DayControls/ESP32_Universal_Controller/IMAGES/ESP32-CTRL-V1_Detail2.png

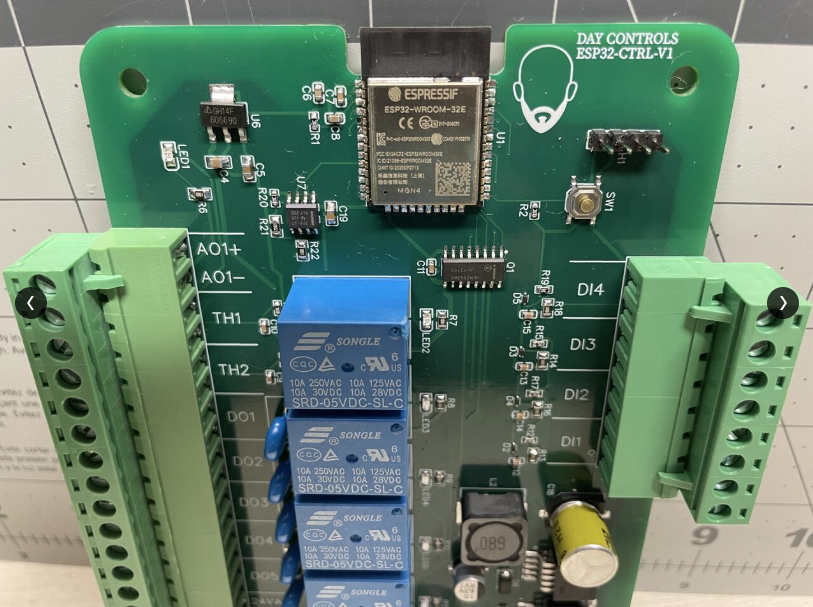
IMAGES/ESP32-CTRL-V1_Detail2.png
