DayControls/ESP32_Universal_Controller/IMAGES/ESP32-CTRL-V1_Completed.png

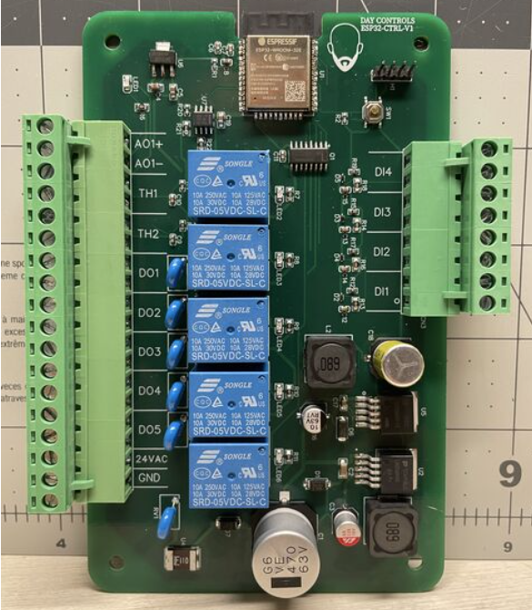
IMAGES/ESP32-CTRL-V1_Completed.png
