DayControls/ESP32_Universal_Controller/README.md

# Universal Programmable Logic Controller (PLC)

A versatile, Wi-Fi-enabled programmable logic controller designed for HVAC, building automation, and general-purpose control applications.

## Features

- **2x Thermistor Inputs** – 10KΩ thermistors
- **4x Digital Inputs** – Dry contact
- **5x Digital Outputs** – Dry contact
- **1x Analog Output** – 0–10 VDC
- **Wi-Fi Connectivity**
- **Bluetooth Connectivity**
