DayControls/ESP32_Universal_Controller/IMAGES/ESP32-CTRL-V2 PCB 3D.png

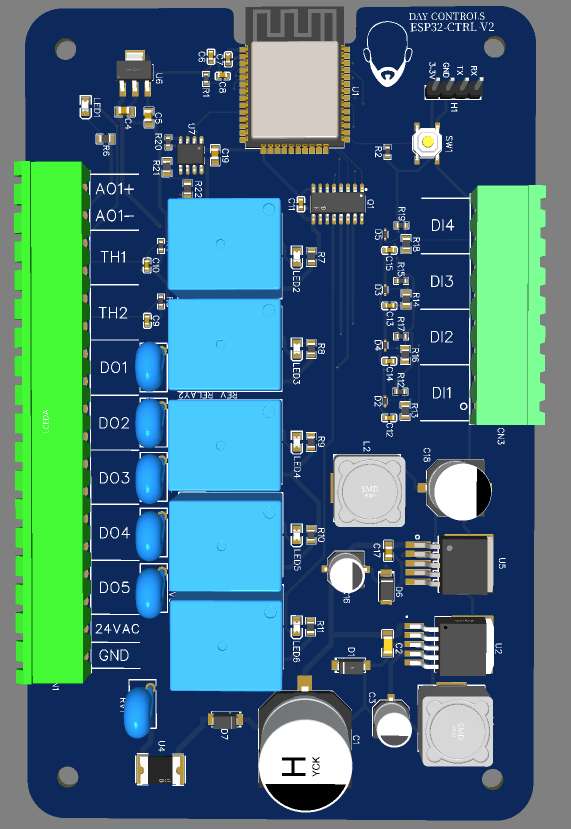
IMAGES/ESP32-CTRL-V2 PCB 3D.png
