DayControls/ESP32_Universal_Controller/IMAGES/ESP32-CTRL-V2 PCB Layout.png

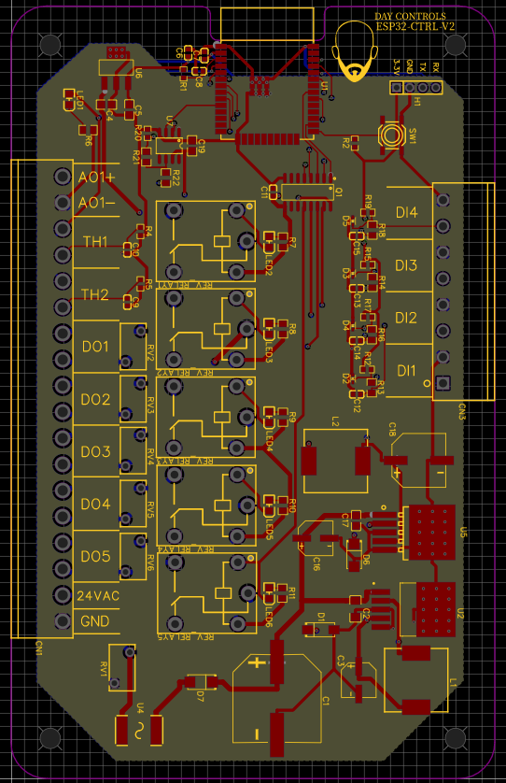
IMAGES/ESP32-CTRL-V2 PCB Layout.png
