DayControls/ESP32_Universal_Controller/IMAGES/ESP32-CTRL-V2_Sample_Use_Case.png

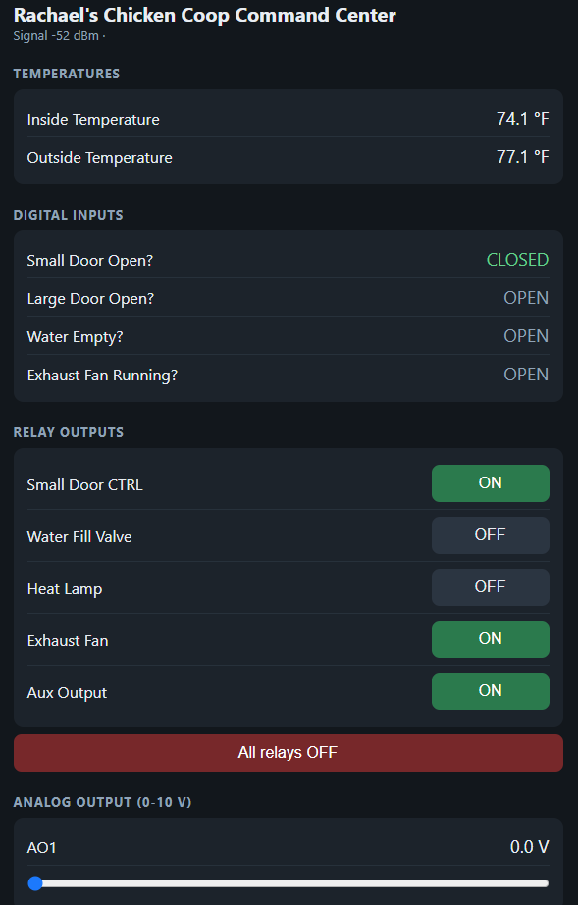
IMAGES/ESP32-CTRL-V2_Sample_Use_Case.png
