DayControls/ESP32_Universal_Controller/MATERIALS/BOM_ESP32-CTRL-V2.csv

ID | Name | Designator | Footprint | Quantity | Manufacturer Part | Manufacturer | Supplier | Supplier Part | Price
1 | M7_C95872 | D7 | SMA_L4.3-W2.6-LS5.2-RD | 1 | M7 | MDD(辰达半导体) | LCSC | C95872 | 0.01
2 | 470uF | C1 | CAP-SMD_BD16.0-L17.0-W17.0-FD | 1 | VE-471M1JTR-1616 | Lelon(立隆) | LCSC | C249548 | 0.745
3 | 1uF | C2 | C1206 | 1 | CC1206KKX7R0BB105 | YAGEO(国巨) | LCSC | C70463 | 0.104
4 | 220uF | C3 | CAP-SMD_BD6.3-L6.6-W6.6-FD | 1 | SS221M160E7R7R4Z00ZZ | CH(创慧电子) | LCSC | C25503905 | 0.102
5 | 10uF | C16 | CAP-SMD_BD6.3-L6.6-W6.6-FD | 1 | RVT1J100M0605 | ROQANG(容强) | LCSC | C72489 | 0.036
6 | 4.7uF | C4,C5 | C0805 | 2 | CL21A475KAQNNNE | SAMSUNG(三星) | LCSC | C1779 | 0.035
7 | 100nF | C17,C19 | C0805 | 2 | TCC0805X7R104K101FT | CCTC(三环) | LCSC | C282731 | 0.012
8 | 10uF | C6 | C0603 | 1 | CL10A106KP8NNNC | SAMSUNG(三星) | LCSC | C19702 | 0.021
9 | 100nF | C7,C9,C10,C11,C12,C13,C14,C15 | C0603 | 8 | 0603B104M500NT | FH(风华) | LCSC | C286510 | 0.004
10 | 1uF | C8 | C0603 | 1 | CL10B105KB8NQNC | SAMSUNG(三星) | LCSC | C5199872 | 0.024
11 | 220uF | C18 | CAP-SMD_BD10.0-L10.3-W10.3-LS11.3-FD | 1 | VKME1301H221MV | Ymin(永铭) | LCSC | C487367 | 0.334
12 | DB2ERC-5.08-18P-GN | CN1 | CONN-TH_18P-P5.08_DB2ERC-5.08-18P-GN | 1 | DB2ERC-5.08-18P-GN | DIBO(地博电气) | LCSC | C430509 | 0.71
13 | XY2500R-D-5.08-8P | CN3 | CONN-TH_8P-P5.08_XY2500R-D5.08-8P | 1 | XY2500R-D-5.08-8P | XINLAIYA(新莱亚) | LCSC | C505830 | 0.283
14 | SS36_C116712 | D1 | SMA_L4.4-W2.8-LS5.4-RD | 1 | SS36 | 晶导微电子 | LCSC | C116712 | 0.036
15 | PESD3V3S1BA-N | D2,D3,D4,D5 | SOD-523_L1.2-W0.8-LS1.6-BI | 4 | PESD3V3S1BA-N | BORN(伯恩半导体) | LCSC | C316037 | 0.039
16 | SS510 | D6 | SMA_L4.3-W2.6-LS5.2-RD | 1 | SS510 | MDD(辰达半导体) | LCSC | C65010 | 0.053
17 | X6511WV-04H-C30D60 | H1 | HDR-TH_4P-P2.54-V-M | 1 | X6511WV-04H-C60D30 | XKB Connection(中国星坤) | LCSC | C706876 | 0.123
18 | 68uH | L1,L2 | IND-SMD_L12.3-W12.3_SMDRI127 | 2 | SMDRI127-680MT | SXN(顺翔诺) | LCSC | C9907 | 0.231
19 | YLED0805G | LED1,LED2,LED3,LED4,LED5,LED6 | LED0805-FD-GREEN | 6 | YLED0805G | YONGYUTAI(永裕泰) | LCSC | C25170728 | 0.011
20 | ULN2003ADR2G | Q1 | SOIC-16_L9.9-W3.9-P1.27-LS6.0-BL | 1 | ULN2003ADR2G | onsemi(安森美) | LCSC | C96639 | 0.287
21 | 10kΩ | R1,R2,R4,R5,R12,R15,R17,R19,R20 | R0603 | 9 | RC0603FR-0710KL | YAGEO(国巨) | LCSC | C98220 | 0.003
22 | 1kΩ | R6,R7,R8,R9,R10,R11,R13,R14,R16,R18,R22 | R0805 | 11 | 0805W8F1001T5E | UNI-ROYAL(厚声) | LCSC | C17513 | 0.004
23 | 22kΩ | R21 | R0805 | 1 | FRC0805F2202TS | FOJAN(富捷) | LCSC | C2907243 | 0.003
24 | SRD-05VDC-SL-C | REV_RELAY1,REV_RELAY2,REV_RELAY3,REV_RELAY4,REV_RELAY5 | RELAY-TH_SRD-XXVDC-XL-C | 5 | SRD-05VDC-SL-C | 松乐 | LCSC | C35449 | 0.448
25 | 1.05nF@1kHz | RV1,RV2,RV3,RV4,RV5,RV6 | RES-TH_L9.0-W5.0-P6.00-D0.7-S3.00 | 6 | 07D560K | RUILON(瑞隆源) | LCSC | C19930 | 0.077
26 | TS-1187-2516 | SW1 | SW-SMD_4P-L5.2-W5.2-P3.70-LS6.4 | 1 | TS-1187-2516 | SOFNG(硕方) | LCSC | C183615 | 0.045
27 | ESP32-WROOM-32E(4MB) | U1 | WIFI-SMD_ESP32-WROOM-32E | 1 | ESP32-WROOM-32E-N4 | ESPRESSIF(乐鑫) | LCSC | C701341 | 3.798
28 | LM2596HVS-5.0 | U2 | TO-263-5_L10.0-W9.0-P1.70-LS15.0-BL | 1 | LM2596HVS-5.0 | TECH PUBLIC(台舟) | LCSC | C18197847 | 1.011
29 | 2920L110/60MR | U4 | F2920 | 1 | 2920L110/60MR | Littelfuse(美国力特) | LCSC | C315903 | 0.424
30 | LM2596HVS-12RG | U5 | PG-TO-263-5_L10.2-W8.7-P1.70-LS14.4-BR | 1 | LM2596HVS-12RG | HGC(深圳汉芯) | LCSC | C22439315 | 0.803
31 | AP2114HA-3.3TRG1 | U6 | SOT-223-3_L6.5-W3.4-P2.30-LS7.0-BR | 1 | AP2114HA-3.3TRG1 | DIODES(美台) | LCSC | C460314 | 0.251
32 | OPA197IDR | U7 | SOIC-8_L4.9-W3.9-P1.27-LS6.0-BL | 1 | OPA197IDR | TI(德州仪器) | LCSC | C79274 | 0.695
