DayControls/ESP32_Universal_Controller/SCHEMATICS/SCHEMATIC (ESP32-CTRL-V2).pdf

# Power Converters

# Analog Output 0-10VDC

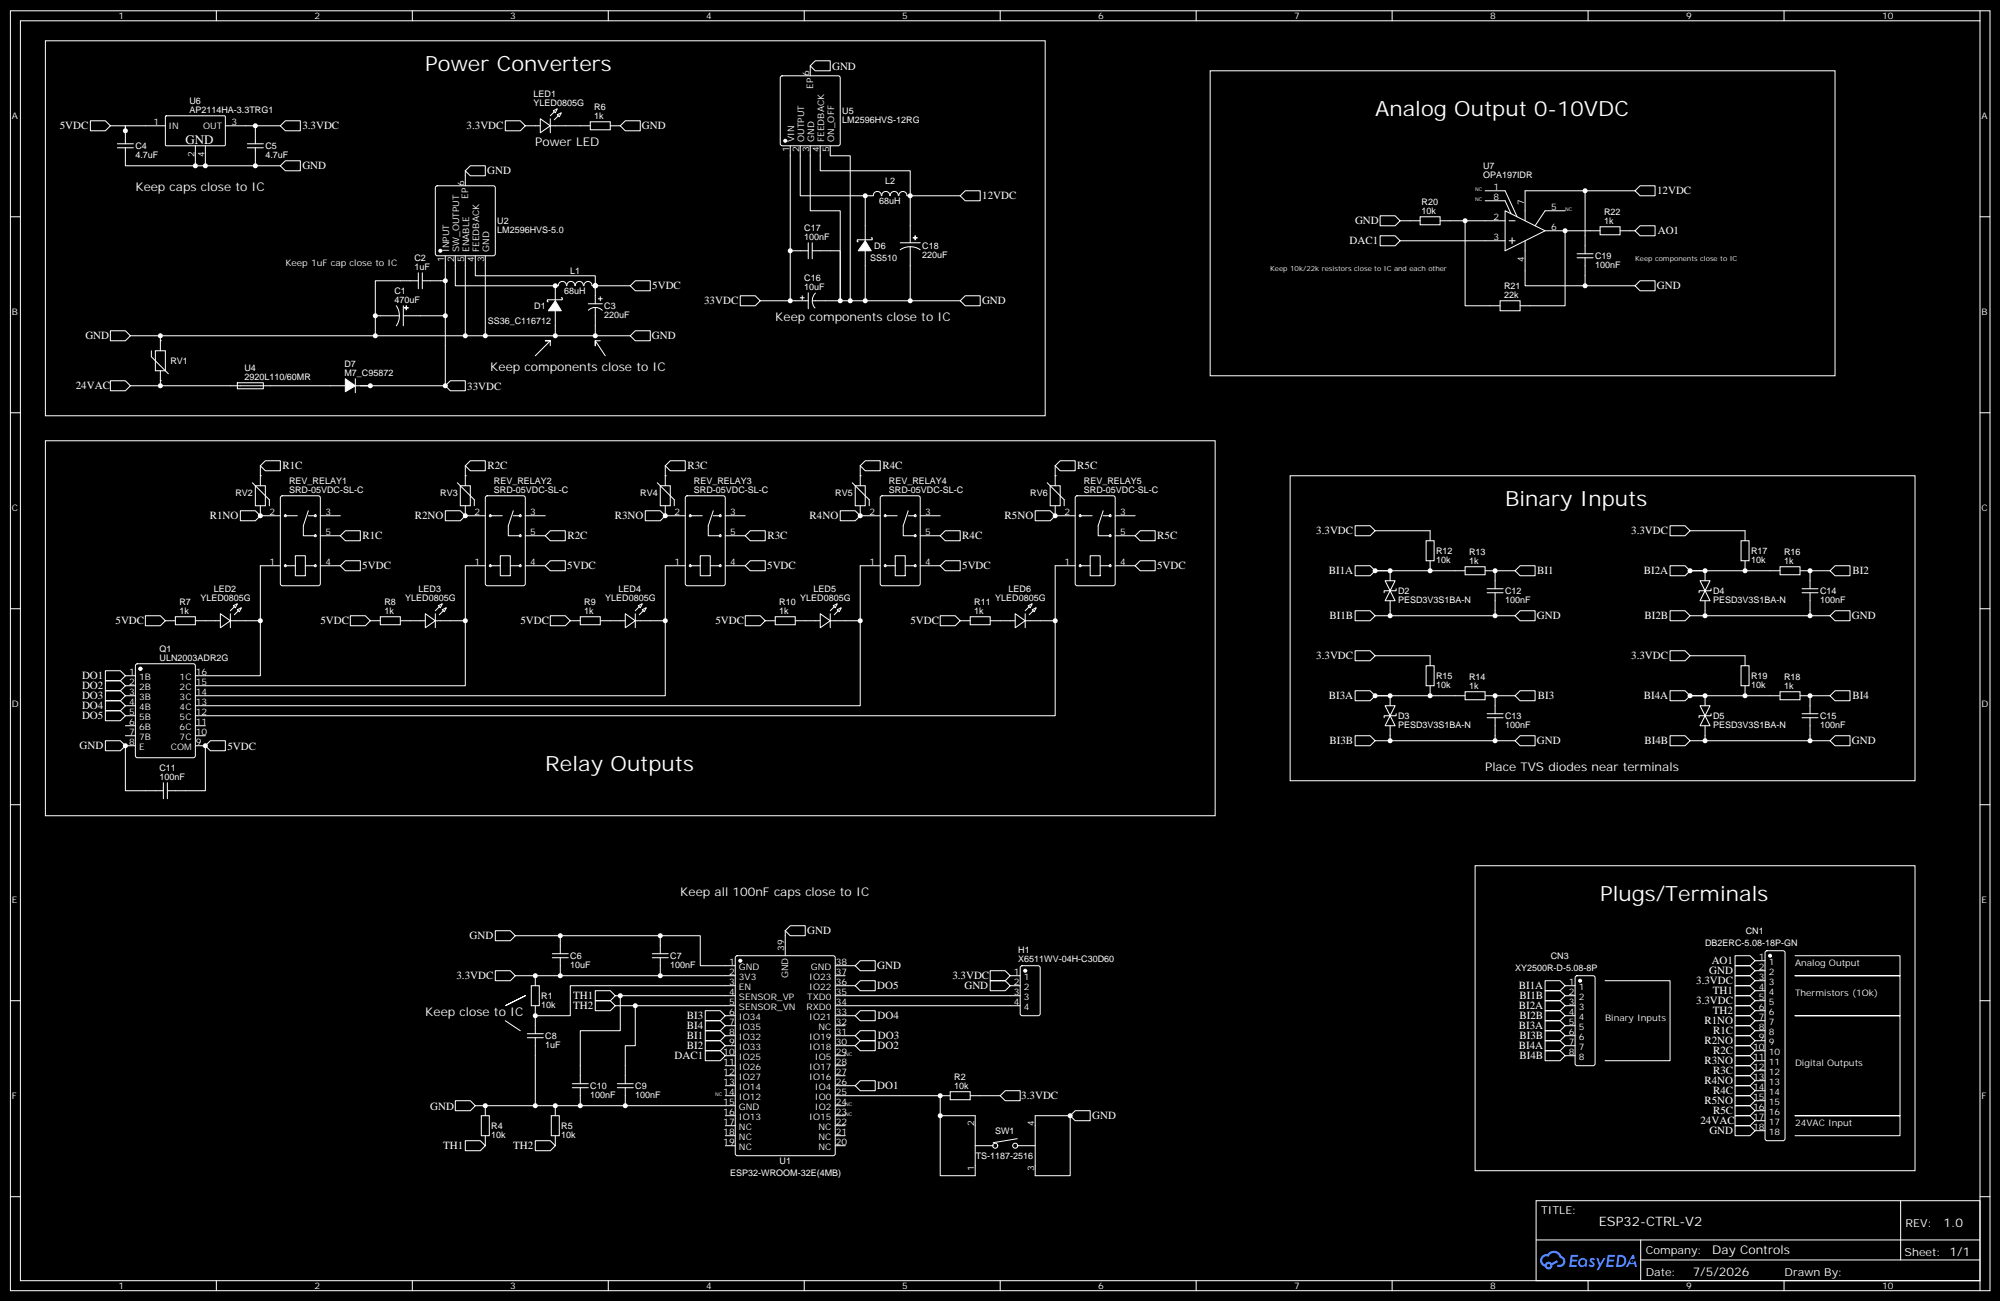
[picture p7: page 1]

Keep caps close to IC

Keep 1uF cap close to IC

Keep components close to IC

Keep 10k/22k resistors close to IC and each other

33VDC

Place TVS diodes near terminals

Keep all 100nF caps close to IC

Keep close to IC
