DayControls/ESP32_Universal_Controller/(list of files, drawings)

Other design files:
EasyEDA/PCB_LAYOUT_ESP32-CTRL-V2.json
EasyEDA/SCHEMATIC_ESP32-CTRL-V2.json
